MATH-286-Pro/ZJUI-Balance-Infantry/modules/Motor/Motor_MI/README.md

# 小米电机驱动
### 开始使用
参考[Wiki](../.wiki/小米电机驱动(STM32F4-HAL库)使用教程.md)

### 体验代码
“让小米电机动起来”工程代码
- [Gitee](https://gitee.com/Ljw0401/let-xiaomi-motor-move)
<!-- - [GitHub]() -->

### 参考资料
[CyberGear微电机使用说明书.pdf](https://gitee.com/SMBU-POLARBEAR/technical-documentation/blob/master/%E7%94%B5%E6%9C%BA/%E5%B0%8F%E7%B1%B3/CyberGear%E5%BE%AE%E7%94%B5%E6%9C%BA%E4%BD%BF%E7%94%A8%E8%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)<br>
[小米微电机STM32 HAL库驱动教程](https://blog.csdn.net/m0_53802226/article/details/132941275)<br>
