MATH-286-Pro/ZJUI-Balance-Infantry/Picture/Config.png

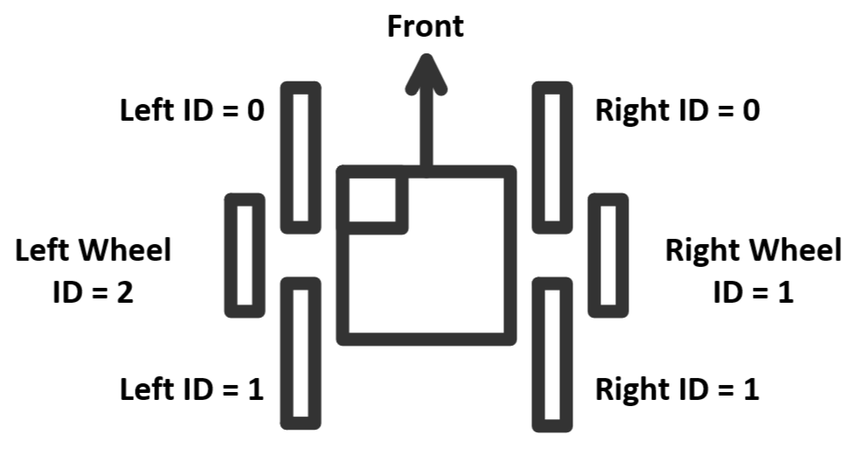
Picture/Config.png
