MATH-286-Pro/ZJUI-Balance-Infantry/Picture/DT7.png

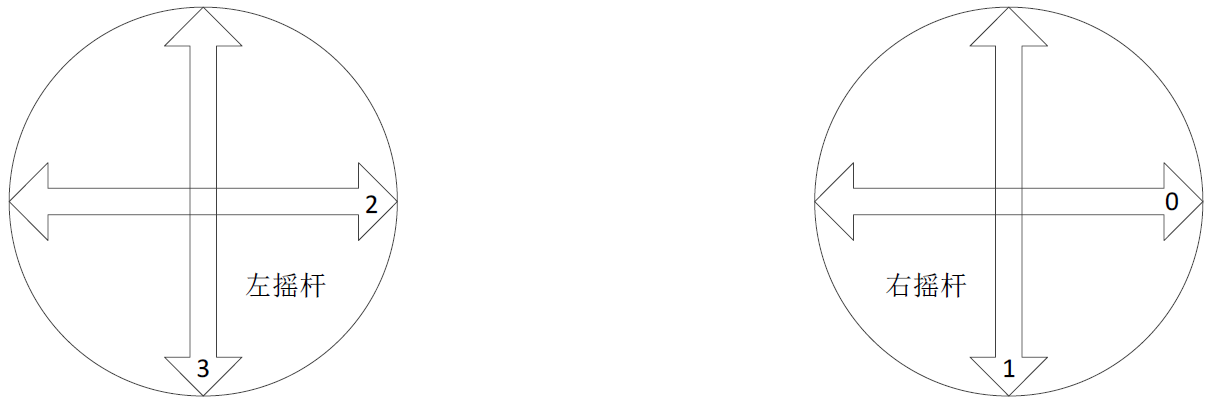
Picture/DT7.png
