MATH-286-Pro/ZJUI-Balance-Infantry/Core/Src/main.c

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
/* Includes ------------------------------------------------------------------*/
#include "main.h"
#include "cmsis_os.h"
#include "can.h"
#include "dma.h"
#include "i2c.h"
#include "spi.h"
#include "tim.h"
#include "usart.h"
#include "usb_device.h"
#include "gpio.h"

/* USER CODE BEGIN Includes */
#include "bsp_init.h"
#include "bsp_buzzer.h"
#include "OLED.h"
#include "ins_task.h"
#include "Callback.h"
#include "can_test.h"
#include "MI_motor_drive.h"
#include "rc.h"
#include "OLED_BMP.h"


/* USER CODE END Includes */


/* USER CODE BEGIN PV */
INS_t *INS_DATA;

/* USER CODE END PV */

void SystemClock_Config(void);
void MX_FREERTOS_Init(void);
/**
  * @brief  The application entry point.
  * @retval int
  */
int main(void)
{
  /* MCU Configuration--------------------------------------------------------*/

  /* Reset of all peripherals, Initializes the Flash interface and the Systick. */
  HAL_Init();

  /* Configure the system clock */
  SystemClock_Config();

  /* Initialize all configured peripherals */
  MX_GPIO_Init();
  MX_DMA_Init();
  MX_I2C2_Init();
  MX_SPI1_Init();
  MX_I2C3_Init();
  MX_TIM10_Init();
  MX_USART3_UART_Init();
  MX_CAN1_Init();
  MX_CAN2_Init();
  MX_TIM4_Init();
  MX_TIM5_Init();
  MX_USART1_UART_Init();
  MX_USART6_UART_Init();
  /* USER CODE BEGIN 2 */

  // 关闭中断,防止在初始化过程中发生中断
  // 请不要在初始化过程中使用中断和延时函数！
  // 若必须,则只允许使用DWT_Delay()
  Buzzer_beep();

  __disable_irq();
  BSPInit();
  OLED_init();
  OLED_clear();
  OLED_show_string(0,0,"Initiating...");
  OLED_refresh_gram();
  Dbus_Init();  
  CAN_Init(&hcan1);   
  CAN_Filter_Mask_Config(&hcan1, CAN_FILTER(0) | CAN_FIFO_0 | CAN_EXTID | CAN_DATA_TYPE, 0, 0); 
  INS_DATA = INS_Init(); // 初始化IMU 测试 不知道为什么要初始化非常久 将近30秒
  OLED_showBMP_gram(BMP_GENSHIN_GRAM);
  
  stand_task_init();
  __enable_irq();

  /* USER CODE END 2 */

  /* Call init function for freertos objects (in freertos.c) */
  MX_FREERTOS_Init();

  /* Start scheduler */
  osKernelStart();

  /* We should never get here as control is now taken by the scheduler */
  /* Infinite loop */
  /* USER CODE BEGIN WHILE */
  while (1)
  {
    /* USER CODE END WHILE */

    /* USER CODE BEGIN 3 */
  }
  /* USER CODE END 3 */
}

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
