MATH-286-Pro/ZJUI-Balance-Infantry/modules/OLED/OLED_BMP.h

/**
  ****************************(C) COPYRIGHT 2023 Daud-117****************************
  * @file       OLED_BMP.h
  * @brief      This file contain the BMP data for OLED_showBMP function
  *             本文件包含OLED_showBMP函数图片数据
  * @note       
  * @history
  *  Version    Date            Author          Modification
  *  V1.0.0     July-23-223     RM              1. done
  *
  @verbatim
  ==============================================================================

  ==============================================================================
  @endverbatim
  ****************************(C) COPYRIGHT 2023 Daud-117****************************
  */
 
#ifndef __OLED__BMP__H
#define __OLED__BMP__H

//一维数组 UNSC 标志 精确
extern unsigned char BMP_UNSC[] =
{
0x00,0x00,0x00,0x00,0x00,0x00,0x00,0x00,0x00,0x00,0x00,0x00,0x00,0x00,0x00,0x00,
0x00,0x00,0x00,0x00,0x00,0x00,0x00,0x00,0x00,0x00,0x00,0x00,0x00,0x00,0x00,0x80,
0x60,0x10,0x28,0x44,0xD0,0x30,0x08,0x04,0x00,0x00,0x00,0x00,0x00,0x00,0x00,0x00,
0x00,0x00,0x00,0x00,0x00,0x00,0x00,0x00,0xC0,0x80,0xE0,0xE0,0xC0,0xC0,0xC0,0xE0,
0xF0,0xF0,0xF0,0xF0,0xF0,0xF0,0xF8,0xF8,0xF8,0xF8,0xF0,0xF0,0xF0,0xF8,0xD0,0xE0,
0xF0,0xF0,0xF0,0xD0,0xE8,0xF0,0xE0,0xF0,0xF0,0xE8,0x70,0x38,0x18,0x0C,0x04,0x02,
0x80,0x80,0xC0,0x40,0x40,0x00,0x00,0x00,0x00,0x00,0x00,0x00,0x00,0x00,0x00,0x00,
0x00,0x00,0x00,0x00,0x00,0x00,0x00,0x00,0x00,0x00,0x00,0x00,0x00,0x00,0x00,0x00,
0x00,0x00,0x00,0x00,0x00,0x00,0x00,0x00,0x00,0x00,0x00,0x00,0x00,0x00,0x00,0x00,
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
{0x00,0x00,0x00,0x00,0x00,0x00,0x00,0x00},
{0x00,0x00,0x00,0x00,0x00,0x00,0x00,0x00},
{0x00,0x00,0x00,0x00,0x00,0x00,0x00,0x00},
{0x00,0x00,0x00,0x00,0x00,0x00,0x00,0x00},
{0x00,0x00,0x00,0x00,0x00,0x00,0x00,0x00},
{0x00,0x00,0x00,0x00,0x00,0x00,0x00,0x00},
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
};

#endif
