MATH-286-Pro/ZJUI-Balance-Infantry/modules/Motor/Motor_MI/Callback.h

#ifndef __CALLBACK_H__
#define __CALLBACK_H__

/* Includes ------------------------------------------------------------------*/
#include "MI_motor_drive.h"

// 声明外部 小米电机变量
extern MI_Motor_s MI_Motor_ID1;
extern MI_Motor_s MI_Motor_ID2;

#endif
