MATH-286-Pro/ZJUI-Balance-Infantry/(commit log)

2024-03-11 功能：遥控+CAN1小米电机+OLED
2024-03-11 添加功能: USART1 可以打印 Hello World, 但是当前 USART1 Baud Rate 被手动修改为 128000
2024-03-11 修改项目：USART1波特率通信测试 + 删除GitHub上的build文件夹，取消跟踪
2024-03-11 修改选项：USART1 不同波特率测试，有一个神奇的现象
2024-03-12 1.Tasks.json 添加烧录任务，可以使用 openocd -c 命令烧录 .hex 文件 2.UART 问题未解决
    [main.c]
2024-03-14 没什么大修改
2024-03-14 Git 测试
2024-03-15 添加 UART6
2024-03-18 [添加] TIM4 蜂鸣器 [测试] TTL转485
2024-03-20 测试 A1_motor_speed_control 函数 (传入值)
2024-03-20 [版本] 可使用遥控驱动A1电机
2024-03-20 [整理]
2024-03-21 [更新] A1电机能正反转
2024-03-23 [更新] 不完全FreeRTOS
2024-03-23 [更新] remote_control.c 中文可见
2024-03-23 [更新] FreeRTOS 可使用 CAN
2024-03-23 [更新] 解决CAN接收中断问题
2024-03-24 [更新] 2个FreeROTS线程解决A1电机延迟问题
2024-03-26 [优化] 优化小米电机+蜂鸣器文件夹
2024-03-26 [优化] OLED 文件夹
2024-03-27 [更新] 编译通过 A1_control.c
2024-03-27 [版本] 移植 unitreeA1_cmd 咔咔声解决
2024-03-27 [版本] A1电机位置模式
2024-03-27 [更新] A1 力矩模式+位置模式
2024-03-27 [更新] A1 位置模式+速度模式+力矩模式
2024-03-27 [优化] A1文件夹结构+急停功能
2024-03-28 [大更新] 找出大连交通Pos问题, 字节拼接反了
2024-04-02 [更新] 优化文件结构
2024-04-03 [更新] 可控制两条腿
2024-04-06 [更新] 双腿位置模式+初始零点
2024-04-06 [更新] 修改freertos.c A1位置模式小bug
2024-04-07 [更新] 修改位置模式 KP KW
2024-04-07 [更新] 无变化
2024-04-07 [更新] Readme.md 结尾致谢
2024-04-08 [更新] 增加A1电机自检0位
2024-04-10 [更新] 封装joint.c包含Joint_Zero_Init()函数
2024-04-10 [更新] 封装A1-Pos自检
2024-04-10 [Debug] 修改freertos.c中Joint_Zero_Init_Type1()
2024-04-11 [Debug] 添加的空函数 Joint_Zero_Init_Type2()会阻止Typr1运行
2024-04-11 [大版本] 上电零点 + 位置模式
2024-04-11 [大版本] 反向移植成功: A1+MI+RC+INS
2024-04-11 [更新] 中文乱码消除
2024-04-12 [测试] 编译通过,尝试Infantry-3遥控器代码
2024-04-12 [测试] 移植rc.c成功,但是初始化需要延时1s
2024-04-12 [测试] RC移植成功,但是wheel一直是0,添加MI差速控制
2024-04-12 [测试]
2024-04-12 [版本] 移植rc.c成功,但是CAN初始化会因为延时太短失败
2024-04-12 [更新] 不需要上电延时也可以初始化 MI 电机
2024-04-12 [更新] 不需要延时上电也可以初始化 MI 电机
2024-04-13 [更新] 增加延时防止MI电机上电过慢跳过初始化问题
2024-04-13 [版本] 添加延时，现在上电MI电机可以启动 + rc.c 移植成功
2024-04-13 [更新] 缩短初始化时间
2024-04-24 [None] 注意之后优化初始化程序
2024-04-24 [更新] 增加DSP库 (arm_math.h 但是会有__SMMLA冲突)
2024-04-24 [更新] A1 电机 变量名称
2024-04-24 [更新] arm_math.h 与 cmsis_gcc.h 冲突
2024-04-24 [更新] user_lib 会使用 arm_math.h 导致冲突
2024-04-25 [更新] 废弃 arm_math.h 中的 arm_sin_fp32，使用 math.h 代替，同时修复遥控器不上电STATE的问题
    [joint.h, rc.h]
2024-04-25 Support arm_math.h and its corresponding lib
    By adding `-larm_cortexM4lf_math` LIBS variable and `-LMiddlewares/ST/ARM/DSP/Lib`
    in its LIBDIR, also define `ARM_MATH_CM4 ARM_MATH_MATRIX_CHECK ARM_MATH_ROUNDING` as
    global marco, and it works.
2024-04-25 [更新] 上传 settings.json (包含 Makefile 插件设置)
2024-04-25 完成A1归位程序,Makefile插件,arm-none-eabi-gcc.exe
2024-04-26 五连杆解算成功
2024-04-27 添加 monitor 监视位置，超出范围关闭A1电机
2024-04-29 添加下限位程序 + fix variable bug
    [joint.c]
2024-05-02 模仿湖南大学，在初始化过程关闭中断
2024-05-04 添加 USB_printf 打印
2024-05-04 板凳模型 使用直立环站立 但是角度过大会震荡发散 待解决
2024-05-07 板凳模型 单直立环 可以前进后退转弯
2024-05-10 封装 Joint_Position_Control() 函数，使其可以控制多个关节
2024-05-10 修复 右后电机零点 bug
2024-05-10 第二套 直立环参数
2024-05-10 速度环 第一套参数 过大角度发散
2024-05-10 速度环 第二套参数
2024-05-10 直立环第三套参数 可以倒地自起
2024-05-10 添加速度环 死区
2024-05-11 封装 Wheel_Torque_Control 函数，不需要思考正负号，优化代码可读性
2024-05-11 目前参数会在0度震荡
2024-05-11 Pitch = 0 不会震荡，但是处于倒地自救边缘，以及速度响应不是很快
2024-05-11 分段速度环 PID, 同时实现倒地自救+防震荡
2024-05-11 修改了速度环I,改为P的1/200
2024-05-12 可以使用VOFA查看角度与速度，增大速度环P，响应速度变快
2024-05-12 速度环当前最好参数 发现原先P过大，OUTMAX过小
2024-05-12 速度环调试完毕
2024-05-12 stand_task_start(INS,LY,RX) 增加输入量，方便跟踪代码输入
2024-05-12 预留跟踪模式
2024-05-15 添加四条腿位置控制
2024-05-15 使用湖南大学陀螺仪结算程序，直立环嵌套速度环
2024-05-15 更改gitignore
2024-05-20 开启腿部控制 + 正确USB打印数据
2024-05-20 修改 USB_printf 打印数据
2024-07-05 修复Picture文件夹丢失问题
2024-07-29 更新 Joint_Zero_init_Type1() Joint_Zero_init_Type2() ，内置归位后速度置零
2024-09-11 Add files via upload
    添加 Fusion 模型文件
2024-09-14 更新说明文档
2024-09-14 添加 CAD 图片
2024-09-17 增加A1电机接线说明
2024-09-25 增加遥控器说明
2024-10-07 增加英文版本
2024-10-07 修正 README.md
